avolk201/procedural-gfx-asic/(commit log)

2026-09-18 feat(rtl): add VGA timing generator with parameterized VESA 640x480@60Hz
    - apu_pkg: shared timing constants, coord_t/rgb332_t types
    - apu_vga_timing: registered outputs, next-state SOF/SOL generation
    - Passes verilator -Wall lint clean
2026-09-18 test(tb): add verilator harness and Makefile for VGA timing
    - sim_main.cpp: cycle-accurate clocking, pulse width measurements, PPM dump
    - Makefile: simple targets for sim, lint, and clean
    - Validates VESA 640x480@60Hz timing metrics (DE count, HSync/VSync widths)
2026-09-19 feat(rtl): wire colorbars into apu_top, capture rgb332 in sim harness
2026-09-19 feat(rtl): add I2C master for ADV7513 HDMI config, 100kHz I2C with START/STOP/ACK protocol, no testing yet.
2026-09-19 test(tb): add verilator harness for I2C master protocol verification
2026-09-20 refactor(rtl): i2c_master core ports oe/in, caller contract in header (D1,D3,D4)
    - drop inout ports from the core; sda_i/scl_i + sda_oe_o/scl_oe_o instead,
    tristate arithmetic deferred to the board wrapper
    - header now specifies the caller contract: hold start_i until busy_o
    (worst case CLK_DIV+1 cycles), hold addresses until done_o, busy-start
    ignored, done_o one tick wide, ack_err_o sticky, oe=1 pulls low
    - add lint_i2c target
    - known B4/B5 (bit_cnt reload, dead STOP) deliberately untouched, fixed
    in a later commit against the rebuilt tb
    [i2c_master.sv]
2026-09-20 refactor: adopt I2C controller/target terminology repo-wide (D14)
    - rtl/i2c_master.sv -> rtl/i2c_controller.sv, module renamed
    - tb identifiers and comments: slave -> target, master -> controller
    - Makefile targets updated; branch master -> main
    - pure rename: lint clean, tb output byte-identical (3 PASS, 7498 cycles)
2026-09-20 fix(rtl): i2c bit_cnt lifecycle - reload after ACK, prime STOP walk (B4,B5)
    - ACK state reloads bit_cnt <= 7 when advancing to SEND_BYTE: bytes 2-3
    now shift out all 8 bits instead of one (B4)
    - ACK primes bit_cnt <= 2 when advancing to STOP: the 3-tick
    SDA-low / SCL-high / SDA-rise sequence runs, so a real STOP condition
    reaches the wire (B5)
    - evidence: tb transaction 7498 -> 14998 cycles (~59 ticks as derived in
    D11); scored bus-level checks land with the tb rewrite
    [i2c_controller.sv]
2026-09-20 test(tb): closed-loop i2c tb - wired-AND bus, target BFM, contract scoreboard (D5,D8-D11)
    - tb is the physical layer: line resolution, pull-ups as logic, write-only
    behavioral ADV7513 (START/STOP detect, MSB-first shift, ninth-clock ACK
    level per D9), all in C++ next to the checks
    - fixed cycle recipe per D8: pre-edge resolve/drive, clock, post-edge
    mirror/classify/step; one-cycle staleness is safe at 250-cycle ticks
    - scoreboard executes the header contract (D11): busy latency, hold-until-
    busy, one START before first data rise, 27 data rises (9/byte, STOP-prep
    rise excluded), bit-exact {dev<<1|0, reg, data} reconstruction, ACK
    levels, one STOP after the last ACK, done_o width m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
    [sim_i2c.cpp]
2026-09-20 fix(tb): vga harness - vsync measured while low, one-frame capture, honest exit code (B6,B7)
    - VSync width now counted in lines between falling and rising edges via
    sol_o; the old SOF-gated counter could never increment and always
    printed 0 (B6). Measures 2 lines per frame.
    - capture exactly frame 1, between SOF 1 and SOF 2: PPM now holds 307200
    px (921615 B) under its 640x480 header, was two frames (1843215 B) (B7).
    docs/frame.png unchanged: reconverted capture is byte-identical, the
    scene is static.
    - assert frame period (420000), HSync width (96 px, every pulse), DE
    total and captured pixel count; nonzero exit on any FAIL (D6 rule 3)
    - drop stale TODO scaffolding and phase ban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
    [sim_main.cpp]
2026-09-20 fix(rtl): apu_pkg declare-before-use order (B8)
    H_TOTAL/V_TOTAL referenced constants declared below them. Verilator
    accepts that, the LRM and stricter parsers (Quartus) do not, and the
    defect would surface on the machine where iteration is slowest.
    Reordered base constants before derived totals. No value changes:
    lint clean, sim measurements and captured frame identical.
    [apu_pkg.sv]
2026-09-20 chore(rtl): drop redundant lint pragma in apu_colorbars
    y_i is already consumed by the _unused_ok reduction at the bottom of
    the module, so the UNUSEDSIGNAL waiver around the port did nothing.
    One waiver per signal, matching i2c_controller. Lint clean, sim output
    identical.
2026-09-22 Add DE10-Nano top wrapper, PLL generator, and pin constraints
2026-09-23 fix(rtl): per-domain reset synchronizers at board top (async assert, sync deassert)
    [de10nano_top.sv, sync_reset.sv]
2026-09-23 fix(rtl): ADV7513 ROM against Programming Guide B, POR to 335 ms (B14)
    [adv7513_config.sv, de10nano_top.sv, sim_adv7513_config.cpp]
2026-09-23 docs: schematic 711128 settles PD/AD, HPD, V11; qsf io standards
2026-09-23 feat(rtl): led3 = 1hz pipeline-alive blink (frame toggle sync), fix stale style-1 comment
    [de10nano_top.sv]
2026-09-23 fix(rtl): pll fractional_vco_multiplier true; derived 1437 MHz VCO out of GP range, never locked (board-verified colorbars)
    [pll_25m.sv]
2026-09-23 fix(constraints): async clock group for pll-domain crossings (B15), drop dead hdmi_tx_int pin
2026-09-24 chore(gitignore): ignore quartus c5 pin dump and __pycache__
2026-09-24 feat(rtl): plasma scene with boiling animation, wired to board
    Two apu_cordic instances drive sin(x)+/-sin(y) into RGB332. de_o is the
    CORDIC's own vld (de delayed 18), so the active window shifts into the porch
    without eating pixels: DE stays 614400, frame still 640x480. frame_x/frame_y
    advance at coprime 257/163 so the interference boils instead of sliding.
    apu_top gains a SCENE param; de10nano_top builds PLASMA, sim stays colorbars.
    Verified: model reproduces the rendered frame 8832/8832 bit-exact.
    [apu_pkg.sv, apu_plasma.sv, apu_top.sv, de10nano_top.sv]
2026-09-24 fix(rtl): three non-collinear gratings make the plasma boil; the two-rate field was provably a slide
    Verified: lint+sim battery green; golden model reproduces the rendered frame 307200/307200 exact.
    [apu_plasma.sv]
2026-09-24 test(tb): plasma look-check harness (make sim_plasma, +frame=N window)
    Captures one scene frame to sim/plasma_frame.ppm for eyeballing against the
    anim/render.py prototype. Timing stays sim_main's job; this target only
    proves the capture holds a full 307200-px frame (D6).
2026-09-24 fix(rtl): size hue literals so CI's older Verilator sees no WIDTHEXPAND
    3'(7-q3) forced the 3-bit q3 to expand to the 32-bit literal's width; CI's
    apt Verilator flags that under -Wall while local 5.050 tolerates it. Sized
    literals (3'd7 - q3) keep both operands 3-bit, clean under either.
    [apu_plasma.sv]
2026-09-25 docs: plasma gif from sim captures and board video in readme; bring-up photo moves to v0.1.0
2026-09-25 docs: B17/D18 DE alignment finding, plasma build evidence, board video as mp4
2026-09-25 fix(rtl): back-porch prefetch aligns scene de_o to the VESA active window (D18)
    [apu_plasma.sv, apu_top.sv, apu_vga_timing.sv, sim_plasma.cpp]
2026-09-27 docs: reserve CORDIC coprocessor regif slot, build gated on M1 and measured need
2026-09-27 feat(tools): rv32 assembler, GNU-as-like subset, 101-check golden suite mutation-drilled
2026-09-27 feat(tools): rv32enc shared encoding tables, pack/unpack, 246-check suite mutation-drilled
2026-09-27 feat(tools): rv32 assembler on shared tables, 101-check golden suite, ISS decode adapter
2026-09-27 docs: B19 la oracle inversion, tools suites in the inventory, contract dialect record
2026-09-27 Update README with project status and features
    Added sections detailing current functionality and pending features.
2026-09-28 fix(rtl): drop syncthreads quartus ignores, specify u_sync_rst_pix chain for mtbf
    [de10nano_top.sv, sync_reset.sv]
2026-09-29 feat(tools): rv32iss step 1, op and op-imm with csv trace, 41-check suite in ci
2026-09-29 docs: frozen cosim trace format, iss inventory row, mutation ledger
2026-09-29 docs: b20, reset-chain mtbf corrected, pages site with d18 artifacts and timing post
2026-09-29 feat(rtl): sixth assertion de-not-in-vsync, sync_reset waiver rationale
2026-09-29 feat(make): pin cordic golden hex sha256, fail on environment drift
2026-09-29 feat(iss): add memory lane checks and mutation ledger
2026-09-29 docs(cpu): define ISS memory trace contract
2026-09-29 docs: iss ledger gains x0-side-effect and right-justify sightings
2026-09-29 fix(rtl): assertion guard flops reset and disable iff, xprop-clean
    [apu_vga_timing.sv, i2c_controller.sv]
2026-09-29 docs: tikz block diagram source, clock-domain and de-routing fixes, rendered png
2026-10-03 docs: ISS step-3 inventory, control-transfer mutation ledger, B21
